akseliahonpera/embedded_systems_course_26/README.md

# embedded_systems_course_26
Repo for embedded systems course project in uni Oulu. Project theme is a drone system.

asdf
