akseliahonpera/embedded_systems_course_26/KiCad_libraries/readme.txt

Tänne saa laittaa komponentit mitä tarvii projektissa.

Näyttää siltä että seuraaville komponenteille tarvii footprintit ja symbolit:
BMP581
M20048-1
MP2235S

En tiiä liekkö netissä symboleita ja footprinttejä valmiina. ei kyllä pitäis olla paha homma tehdä itse.
