akseliahonpera/embedded_systems_course_26/bom.xls

Reference | Qty | Value | DNP | Footprint | DigiKey | Price / pcs | Price
C5,C27 | 2 | 22u |  | Capacitor_SMD:C_1206_3216Metric_Pad1.33x1.80mm_HandSolder | 587-3246-1-ND | 0.08 | 0.16
C6,C8,C15,C16,C18,C19,C20,C22,C23,C24 | 10 | 0.1u |  | Capacitor_SMD:C_0805_2012Metric_Pad1.18x1.45mm_HandSolder | 720-1754-1-ND | 0.18 | 1.8
C7,C10 | 2 | 2.2u |  | Capacitor_SMD:C_0805_2012Metric_Pad1.18x1.45mm_HandSolder | 399-C0805C225K4RACTUCT-ND | 0.36 | 0.72
C9,C11,C12,C13,C14 | 5 | 22p |  | Capacitor_SMD:C_0805_2012Metric_Pad1.18x1.45mm_HandSolder | 399-17625-1-ND | 0.11 | 0.55
C17 | 1 | 22n |  | Capacitor_SMD:C_0805_2012Metric_Pad1.18x1.45mm_HandSolder | 490-1644-1-ND | 0.21 | 0.21
C21 | 1 | 33p |  | Capacitor_SMD:C_0805_2012Metric_Pad1.18x1.45mm_HandSolder | 399-C0805C330J5GACTUCT-ND | 0.09 | 0.09
C25,C26 | 2 | 0 |  | Capacitor_SMD:C_1206_3216Metric_Pad1.33x1.80mm_HandSolder |  |  | 0 | Just extra pad, doesn’t cost anything
D1 | 1 | LED |  | LED_SMD:LED_0805_2012Metric_Pad1.15x1.40mm_HandSolder | 492-2281-1-ND | 0.56 | 0.56
D2 | 1 | D_Schottky |  | Diode_SMD:D_SOD-323_HandSoldering | CUS10S30H3FCT-ND | 0.18 | 0.18
D3 | 1 | 1N4148 |  | Diode_SMD:D_SOD-323F | 1N4148WSFSCT-ND | 0.09 | 0.09
J1 | 1 | Conn_01x08_Socket |  | Connector_PinSocket_2.54mm:PinSocket_1x08_P2.54mm_Vertical |  |  | 0
J2 | 1 | USB4105-GF-A |  | 1_project_library:USB4105_GCT | 2073-USB4105-GF-ACT-ND | 0.67 | 0.67
L1,L2 | 2 | 47n |  | Inductor_SMD:L_0805_2012Metric_Pad1.05x1.20mm_HandSolder | 445-1032-1-ND | 0.09 | 0.18
L3 | 1 | 1.8n |  | Inductor_SMD:L_0805_2012Metric_Pad1.05x1.20mm_HandSolder | 2035-1135-1-ND | 0.14 | 0.14
L4 | 1 | SRU1038-5R0Y |  | 1_project_library:IND_BOURNS_SRU1038 | SRU1038-5R0YCT-ND | 0.69 | 0.69
Q2 | 1 | DMP3099L |  | Package_TO_SOT_SMD:SOT-23 | DMP3099L-7DICT-ND | 0.27 | 0.27
R1,R17,R18,R21,R22 | 5 | 2.2k |  | Resistor_SMD:R_0805_2012Metric_Pad1.20x1.40mm_HandSolder | 311-2.20KCRCT-ND | 0.09 | 0.45
R6,R7 | 2 | 5.1k |  | Resistor_SMD:R_0805_2012Metric_Pad1.20x1.40mm_HandSolder | P5.1KDACT-ND | 0.09 | 0.18
R8 | 2 | 10K |  | Resistor_SMD:R_0805_2012Metric_Pad1.20x1.40mm_HandSolder | 541-10.0KCCT-ND | 0.09 | 0.18
R9,R20 | 2 | 0 |  | Resistor_SMD:R_0805_2012Metric_Pad1.20x1.40mm_HandSolder | 311-0.0ARCT-ND | 0.09 | 0.18
R10 | 1 | 100k |  | Resistor_SMD:R_0805_2012Metric_Pad1.20x1.40mm_HandSolder | 311-100KCRCT-ND | 0.09 | 0.09
R11 | 1 | 20 |  | Resistor_SMD:R_0805_2012Metric_Pad1.20x1.40mm_HandSolder | 311-20.0CRCT-ND | 0.09 | 0.09
R12 | 1 | 5.6k |  | Resistor_SMD:R_0805_2012Metric_Pad1.20x1.40mm_HandSolder | 13-RC0805FR-135K6LCT-ND | 0.09 | 0.09
R13 | 1 | 13k |  | Resistor_SMD:R_0805_2012Metric_Pad1.20x1.40mm_HandSolder | 13-RT0805FRE0713KLCT-ND | 0.09 | 0.09
R14 | 1 | 40.2k |  | Resistor_SMD:R_0805_2012Metric_Pad1.20x1.40mm_HandSolder | 311-40.2KCRCT-ND | 0.09 | 0.09
R15 | 1 | 470k |  | Resistor_SMD:R_0805_2012Metric_Pad1.20x1.40mm_HandSolder | 311-470KCRCT-ND | 0.09 | 0.09
R16,R23 | 2 | 10k |  | Resistor_SMD:R_0805_2012Metric_Pad1.20x1.40mm_HandSolder | 541-10.0KCCT-ND | 0.09 | 0.18
U1 | 1 | B3U-1000P |  | B3U-1000P | SW1020CT-ND | 0.75 | 0.75
U2 | 1 | 1060 |  | 1_project_library:1060_KEY | 36-1060-ND | 1.16 | 1.16
U7 | 1 | LTC4412xS6 |  | Package_TO_SOT_SMD:TSOT-23-6 | 505-LTC4412ES6#TRMPBFCT-ND | 4.31 | 4.31
U8 | 1 | ~ |  | Package_TO_SOT_SMD:TSOT-23-8 | 1589-1573-1-ND | 1.43 | 1.43
U10 | 1 | M20048-1 |  | 1_project_library:QFN28_M20048-1_ANT | 627-1099-1-ND | 14.48 | 14.48
U11 | 1 | BMP581 |  | 1_project_library:QFN10_BMP581_BOS | 828-BMP581CT-ND | 2.5 | 2.5
U12 | 1 | ESP32-S3-MINI-1U |  | RF_Module:ESP32-S2-MINI-1U | 1965-ESP32-S3-MINI-1U-N8CT-ND | 4.52 | 4.52
U13 | 1 | BNO085 |  | 1_project_library:BNO085 | 1888-1006-1-ND | 11.17 | 11.17
 | 1 | ST0126-30-501-A |  |  | 115-ST0126-30-501-A-ND | 9.39 | 9.39
 | 1 | CAB.A02 |  |  | 931-1100-ND | 3.41 | 3.41
 | 1 | SLW-171175-7A-N-D |  |  | 2223-SLW-171175-7A-N-D-ND | 0.48 | 0.48
 |  |  |  |  |  |  | 61.62
