akseliahonpera/embedded_systems_course_26/software/opengl_visualization_app/src/assets/drone.obj

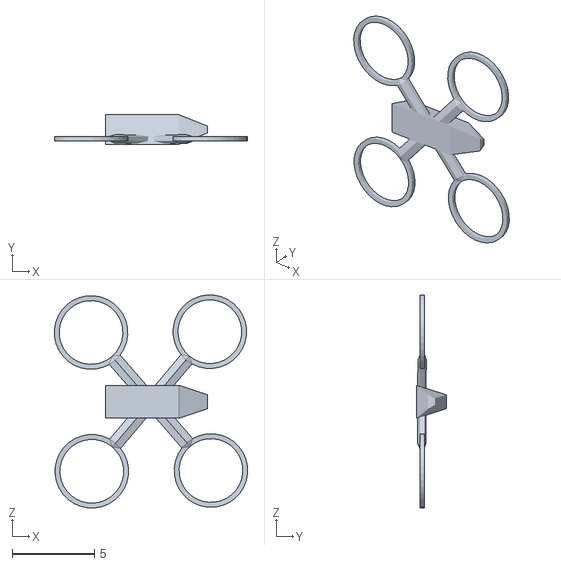
[picture p1: CAD file, 2026-09-06]
software/opengl_visualization_app/src/assets/drone.obj
11.8 x 1.80 x 13.0
