akseliahonpera/embedded_systems_course_26/software/opengl_visualization_app/src/assets/prop.obj

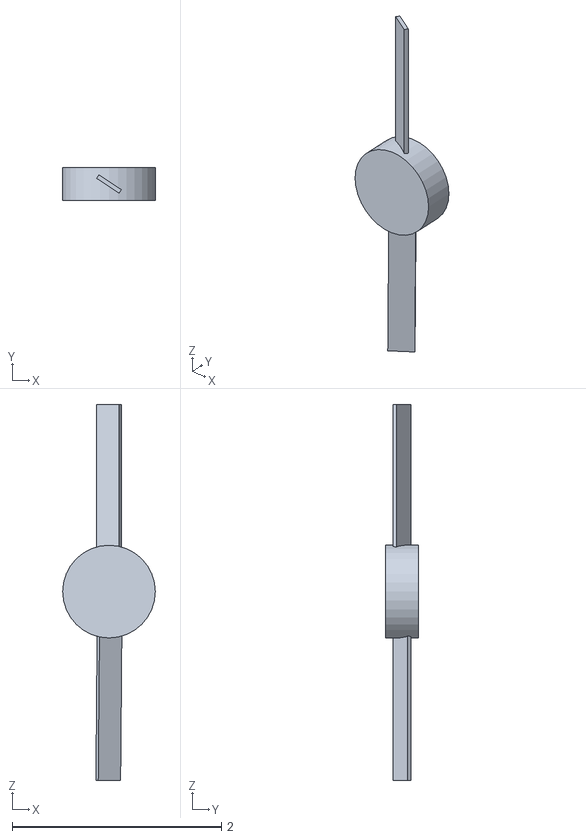
[picture p2: CAD file, 2026-09-06]
software/opengl_visualization_app/src/assets/prop.obj
0.886 x 0.314 x 3.59
