akseliahonpera/embedded_systems_course_26/KiCad_files/esp.kicad_pcb

## KiCad design KiCad_files/esp.kicad_pcb (2026-04-12)

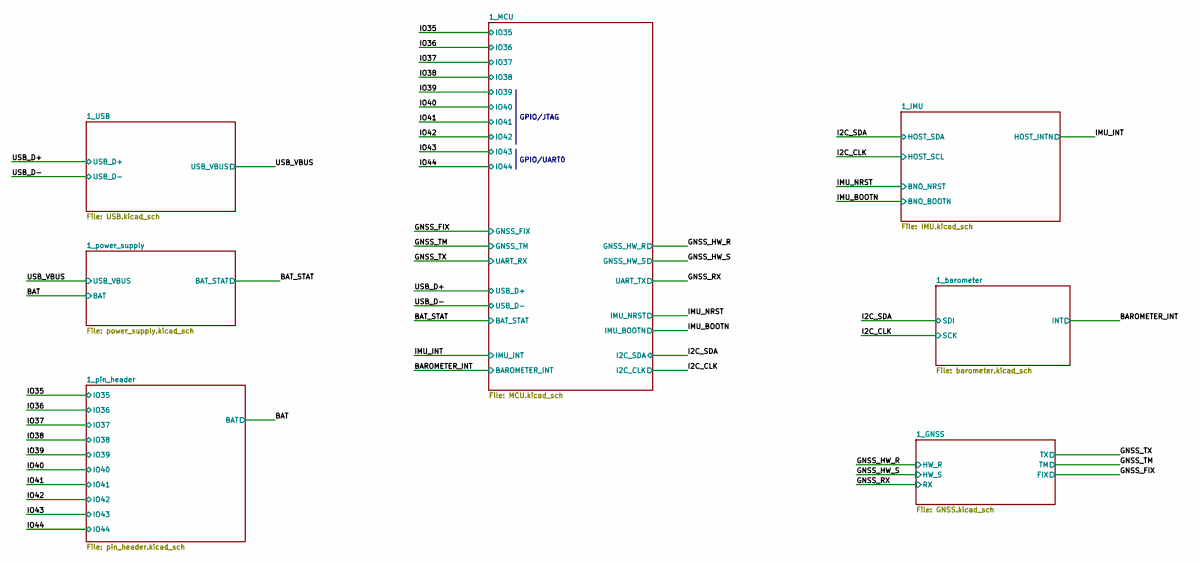
[picture p3: schematic esp.kicad_sch]

Notes on the sheet:
GPIO/JTAG
GPIO/UART0

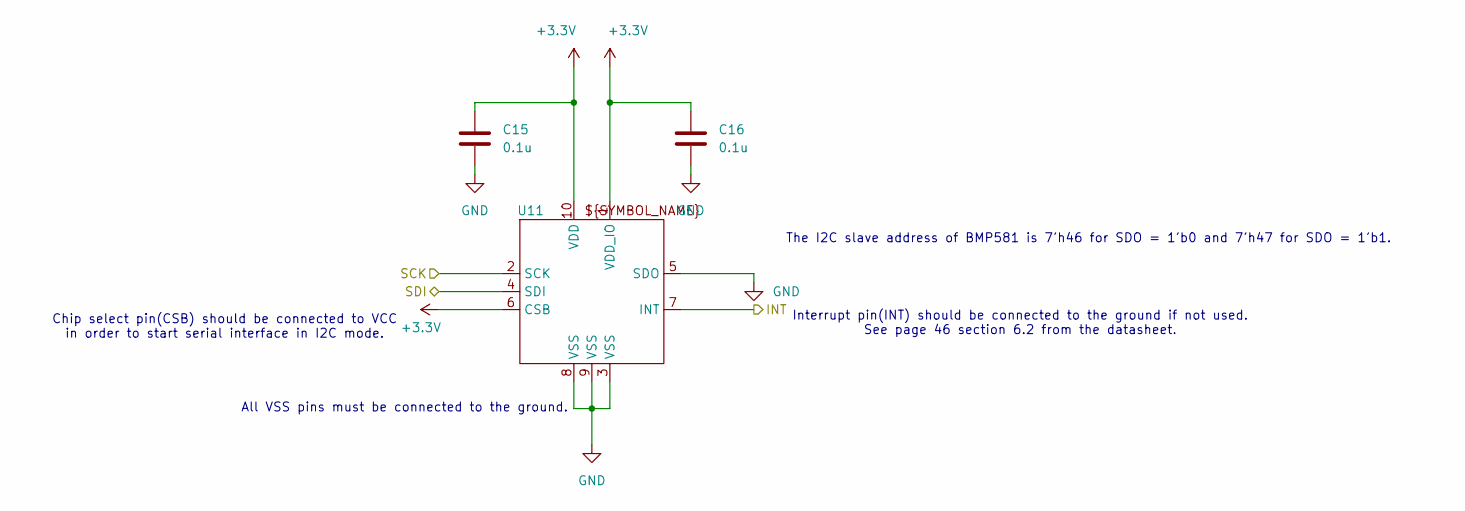
[picture p4: schematic barometer.kicad_sch]

Parts:
C15, C16: 0.1u; C_0805_2012Metric_Pad1.18x1.45mm_HandSolder; DigiKey 720-1754-1-ND
U11: QFN10_BMP581_BOS; DigiKey 828-BMP581CT-ND

Connections:
+3.3V: C15.1, C16.1, U11.1 (VDD_IO), U11.6 (CSB), U11.10 (VDD); also elsewhere on the board
/BAROMETER_INT: U11.7 (INT); also elsewhere on the board
/I2C_CLK: U11.2 (SCK); also elsewhere on the board
/I2C_SDA: U11.4 (SDI); also elsewhere on the board
GND: C15.2, C16.2, U11.3 (VSS), U11.5 (SDO), U11.8 (VSS), U11.9 (VSS); also elsewhere on the board

Notes on the sheet:
Chip select pin(CSB) should be connected to VCC in order to start serial interface in I2C mode.
The I2C slave address of BMP581 is 7'h46 for SDO = 1'b0 and 7'h47 for SDO = 1'b1.
All VSS pins must be connected to the ground.
Interrupt pin(INT) should be connected to the ground if not used. See page 46 section 6.2 from the datasheet.

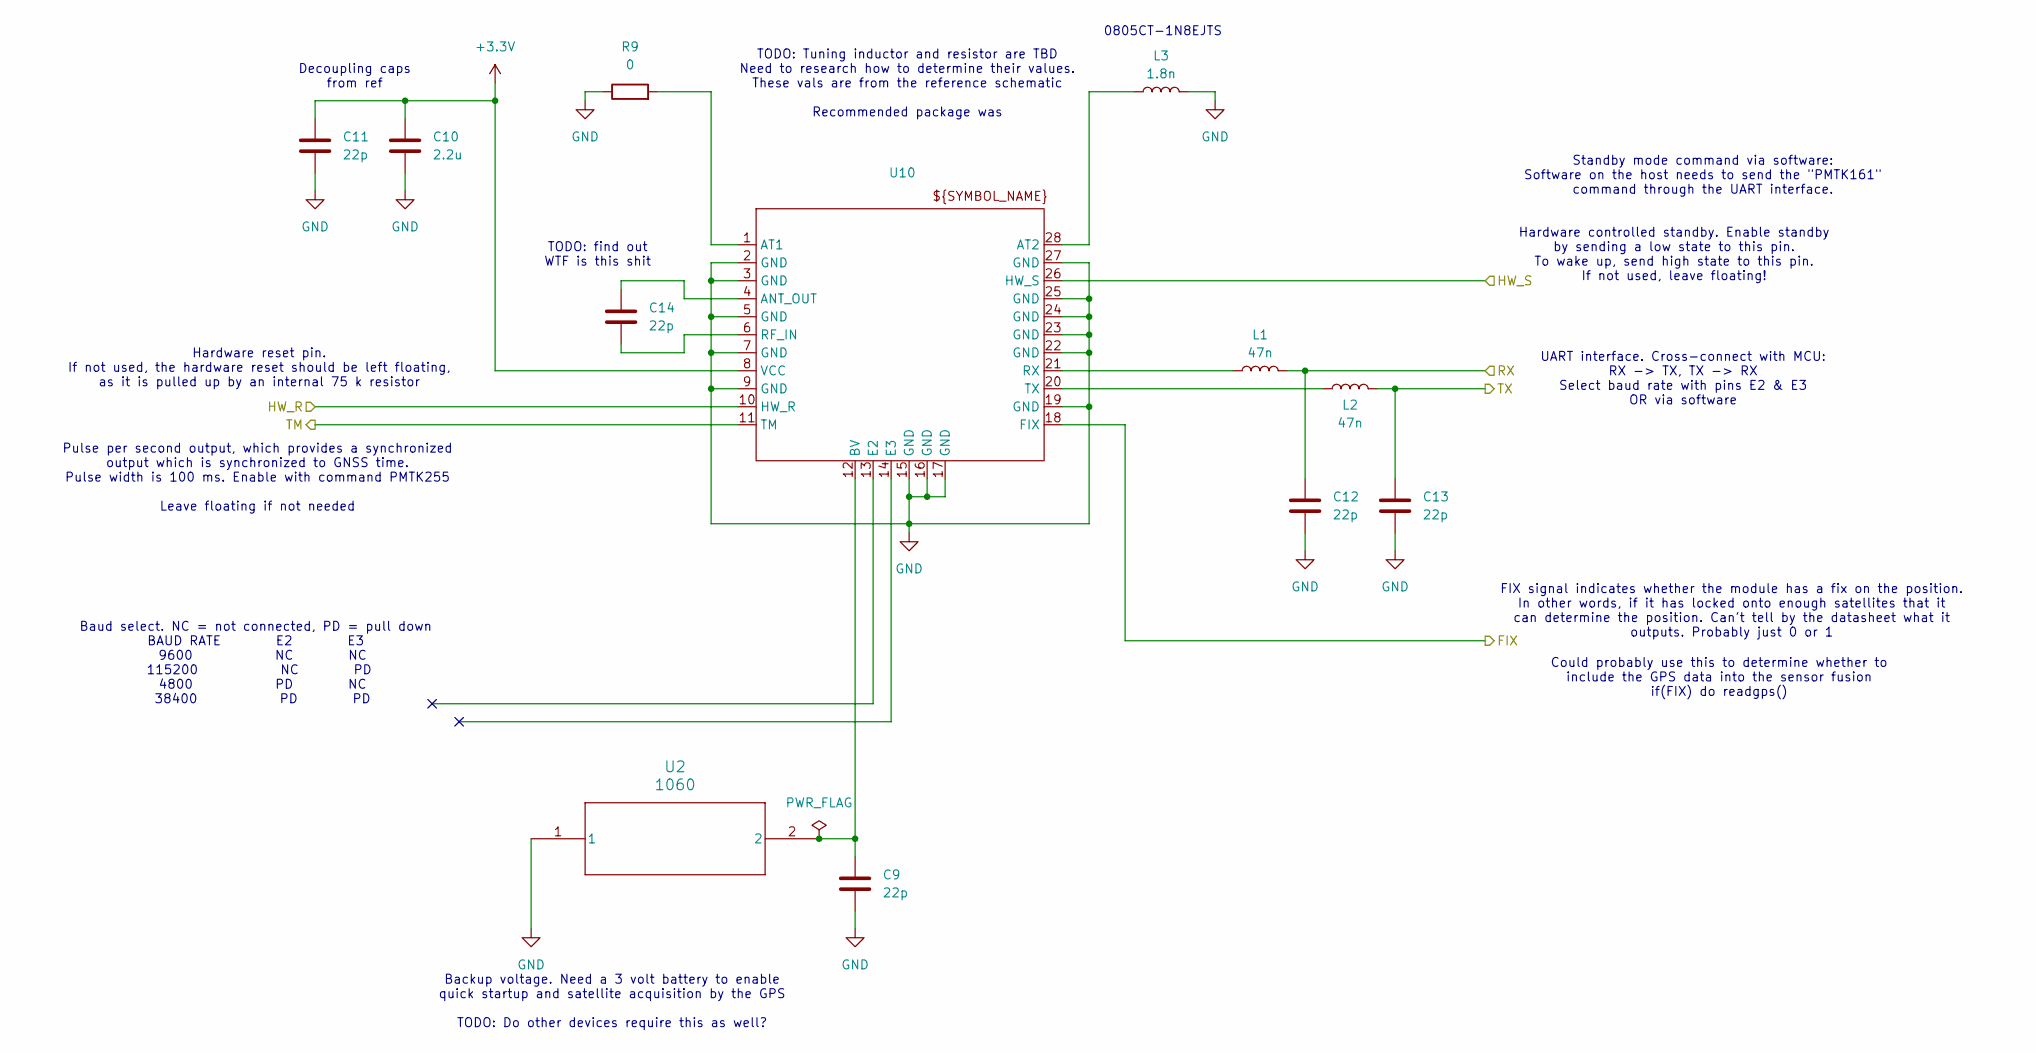
[picture p5: schematic GNSS.kicad_sch]

Parts:
C9, C11, C12, C13, C14: 22p; C_0805_2012Metric_Pad1.18x1.45mm_HandSolder; DigiKey 399-17625-1-ND
C10: 2.2u; C_0805_2012Metric_Pad1.18x1.45mm_HandSolder; DigiKey 399-C0805C225K4RACTUCT-ND
L1, L2: 47n; L_0805_2012Metric_Pad1.05x1.20mm_HandSolder; DigiKey 445-1032-1-ND
L3: 1.8n; L_0805_2012Metric_Pad1.05x1.20mm_HandSolder; DigiKey 2035-1135-1-ND
R9: 0; R_0805_2012Metric_Pad1.20x1.40mm_HandSolder; DigiKey 311-0.0ARCT-ND
U2: 1060; 1060_KEY; DigiKey 36-1060-ND
U10: QFN28_M20048-1_ANT; DigiKey 627-1099-1-ND

Connections:
+3.3V: C10.1, C11.1, U10.8 (VCC); also elsewhere on the board
/GNSS_FIX: U10.18 (FIX); also elsewhere on the board
/GNSS_HW_R: U10.10 (HW_R); also elsewhere on the board
/GNSS_HW_S: U10.26 (HW_S); also elsewhere on the board
/GNSS_RX: C12.1, L1.2; also elsewhere on the board
/GNSS_TM: U10.11 (TM); also elsewhere on the board
/GNSS_TX: C13.1, L2.2; also elsewhere on the board
GND: C9.2, C10.2, C11.2, C12.2, C13.2, L3.2, R9.1, U2.1, U10.2 (GND), U10.3 (GND), U10.5 (GND), U10.7 (GND), U10.9 (GND), U10.15 (GND), U10.16 (GND), U10.17 (GND), U10.19 (GND), U10.22 (GND), U10.23 (GND), U10.24 (GND), U10.25 (GND), U10.27 (GND); also elsewhere on the board
unnamed: C14.1, U10.4 (ANT_OUT)
unnamed: R9.2, U10.1 (AT1)
unnamed: L3.1, U10.28 (AT2)
unnamed: C9.1, U2.2, U10.12 (BV)
unnamed: C14.2, U10.6 (RF_IN)
unnamed: L1.1, U10.21 (RX)
unnamed: L2.1, U10.20 (TX)

Notes on the sheet:
Backup voltage. Need a 3 volt battery to enable quick startup and satellite acquisition by the GPS TODO: Do other devices require this as well?
Could probably use this to determine whether to include the GPS data into the sensor fusion if(FIX) do readgps()
UART interface. Cross-connect with MCU: RX -> TX, TX -> RX Select baud rate with pins E2 & E3 OR via software
0805CT-1N8EJTS
Hardware reset pin. If not used, the hardware reset should be left floating, as it is pulled up by an internal 75 k resistor
Baud select. NC = not connected, PD = pull down BAUD RATE E2 E3 9600 NC NC 115200 NC PD 4800 PD NC 38400 PD PD
TODO: Tuning inductor and resistor are TBD Need to research how to determine their values. These vals are from the reference schematic Recommended package was
FIX signal indicates whether the module has a fix on the position. In other words, if it has locked onto enough satellites that it can determine the position. Can't tell by the datasheet what it outputs. Probably just 0 or 1
Pulse per second output, which provides a synchronized output which is synchronized to GNSS time. Pulse width is 100 ms. Enable with command PMTK255 Leave floating if not needed
Hardware controlled standby. Enable standby by sending a low state to this pin. To wake up, send high state to this pin. If not used, leave floating!
Standby mode command via software: Software on the host needs to send the "PMTK161" command through the UART interface.
TODO: find out WTF is this shit
Decoupling caps from ref

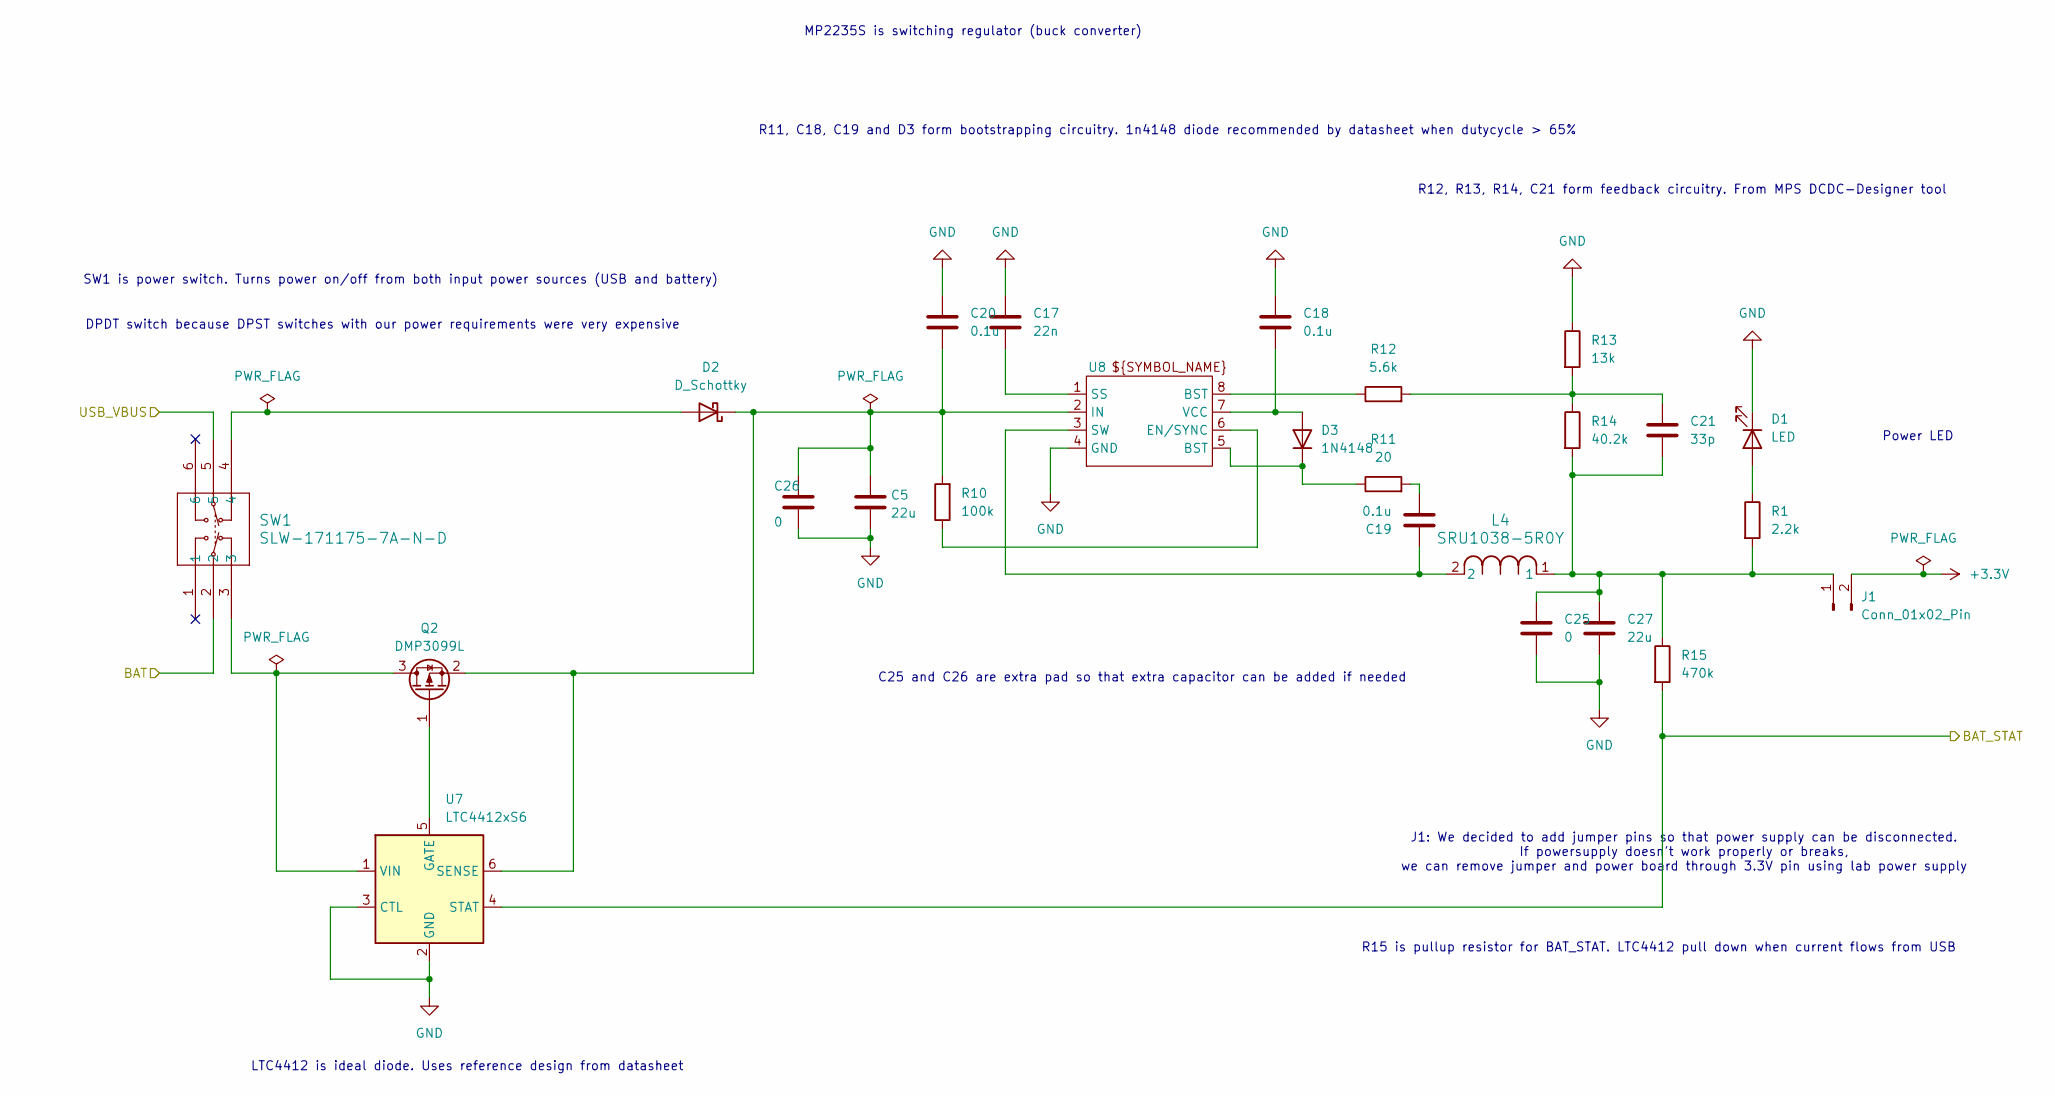
[picture p6: schematic power_supply.kicad_sch]

Parts:
C5, C27: 22u; C_1206_3216Metric_Pad1.33x1.80mm_HandSolder; DigiKey 587-3246-1-ND
C17: 22n; C_0805_2012Metric_Pad1.18x1.45mm_HandSolder; DigiKey 490-1644-1-ND
C18, C19, C20: 0.1u; C_0805_2012Metric_Pad1.18x1.45mm_HandSolder; DigiKey 720-1754-1-ND
C21: 33p; C_0805_2012Metric_Pad1.18x1.45mm_HandSolder; DigiKey 399-C0805C330J5GACTUCT-ND
C25, C26: 0; C_1206_3216Metric_Pad1.33x1.80mm_HandSolder
D1: LED; LED_0805_2012Metric_Pad1.15x1.40mm_HandSolder; DigiKey 492-2281-1-ND
D2: D_Schottky; D_SOD-323_HandSoldering; DigiKey CUS10S30H3FCT-ND
D3: 1N4148; D_SOD-323F; DigiKey 1N4148WSFSCT-ND
J1: Conn_01x02_Pin; PinHeader_1x02_P2.54mm_Vertical
L4: SRU1038-5R0Y; IND_BOURNS_SRU1038; DigiKey SRU1038-5R0YCT-ND
Q2: DMP3099L; SOT-23; DigiKey DMP3099L-7DICT-ND
R1: 2.2k; R_0805_2012Metric_Pad1.20x1.40mm_HandSolder; DigiKey 311-2.20KCRCT-ND
R10: 100k; R_0805_2012Metric_Pad1.20x1.40mm_HandSolder; DigiKey 311-100KCRCT-ND
R11: 20; R_0805_2012Metric_Pad1.20x1.40mm_HandSolder; DigiKey 311-20.0CRCT-ND
R12: 5.6k; R_0805_2012Metric_Pad1.20x1.40mm_HandSolder; DigiKey 13-RC0805FR-135K6LCT-ND
R13: 13k; R_0805_2012Metric_Pad1.20x1.40mm_HandSolder; DigiKey 13-RT0805FRE0713KLCT-ND
R14: 40.2k; R_0805_2012Metric_Pad1.20x1.40mm_HandSolder; DigiKey 311-40.2KCRCT-ND
R15: 470k; R_0805_2012Metric_Pad1.20x1.40mm_HandSolder; DigiKey 311-470KCRCT-ND
SW1: SLW-171175-7A-N-D; SLW-171175-7A-N-D_SSD; DigiKey 2223-SLW-171175-7A-N-D-ND
U7: LTC4412xS6; TSOT-23-6; DigiKey 505-LTC4412ES6#TRMPBFCT-ND
U8: TSOT-23-8; DigiKey 1589-1573-1-ND

Connections:
+3.3V: J1.2; also elsewhere on the board
/BAT: SW1.2; also elsewhere on the board
/BAT_STAT: R15.2, U7.4 (STAT); also elsewhere on the board
/USB_VBUS: SW1.5; also elsewhere on the board
GND: C5.2, C17.1, C18.1, C20.1, C25.2, C26.2, C27.2, D1.1 (K), R13.1, U7.2 (GND), U7.3 (CTL), U8.4 (GND); also elsewhere on the board
unnamed: C19.2, R11.2
unnamed: C21.1, R12.2, R13.2, R14.1
unnamed: D1.2 (A), R1.1
unnamed: D2.2 (A), SW1.4
unnamed: C5.1, C20.2, C26.1, D2.1 (K), Q2.2 (S), R10.2, U7.6 (SENSE), U8.2 (IN)
unnamed: C18.2, D3.2 (A), U8.7 (VCC)
unnamed: D3.1 (K), R11.1, U8.5 (BST)
unnamed: C21.2, C25.1, C27.1, J1.1, L4.1, R1.2, R14.2, R15.1
unnamed: Q2.3 (D), SW1.3, U7.1 (VIN)
unnamed: Q2.1 (G), U7.5 (GATE)
unnamed: R12.1, U8.8 (BST)
unnamed: R10.1, U8.6 (EN/SYNC)
unnamed: C17.2, U8.1 (SS)
unnamed: C19.1, L4.2, U8.3 (SW)

Notes on the sheet:
C25 and C26 are extra pad so that extra capacitor can be added if needed
SW1 is power switch. Turns power on/off from both input power sources (USB and battery)
R12, R13, R14, C21 form feedback circuitry. From MPS DCDC-Designer tool
R11, C18, C19 and D3 form bootstrapping circuitry. 1n4148 diode recommended by datasheet when dutycycle > 65%
Power LED
R15 is pullup resistor for BAT_STAT. LTC4412 pull down when current flows from USB
LTC4412 is ideal diode. Uses reference design from datasheet
J1: We decided to add jumper pins so that power supply can be disconnected. If powersupply doesn't work properly or breaks, we can remove jumper and power board through 3.3V pin using lab power supply
MP2235S is switching regulator (buck converter)
DPDT switch because DPST switches with our power requirements were very expensive

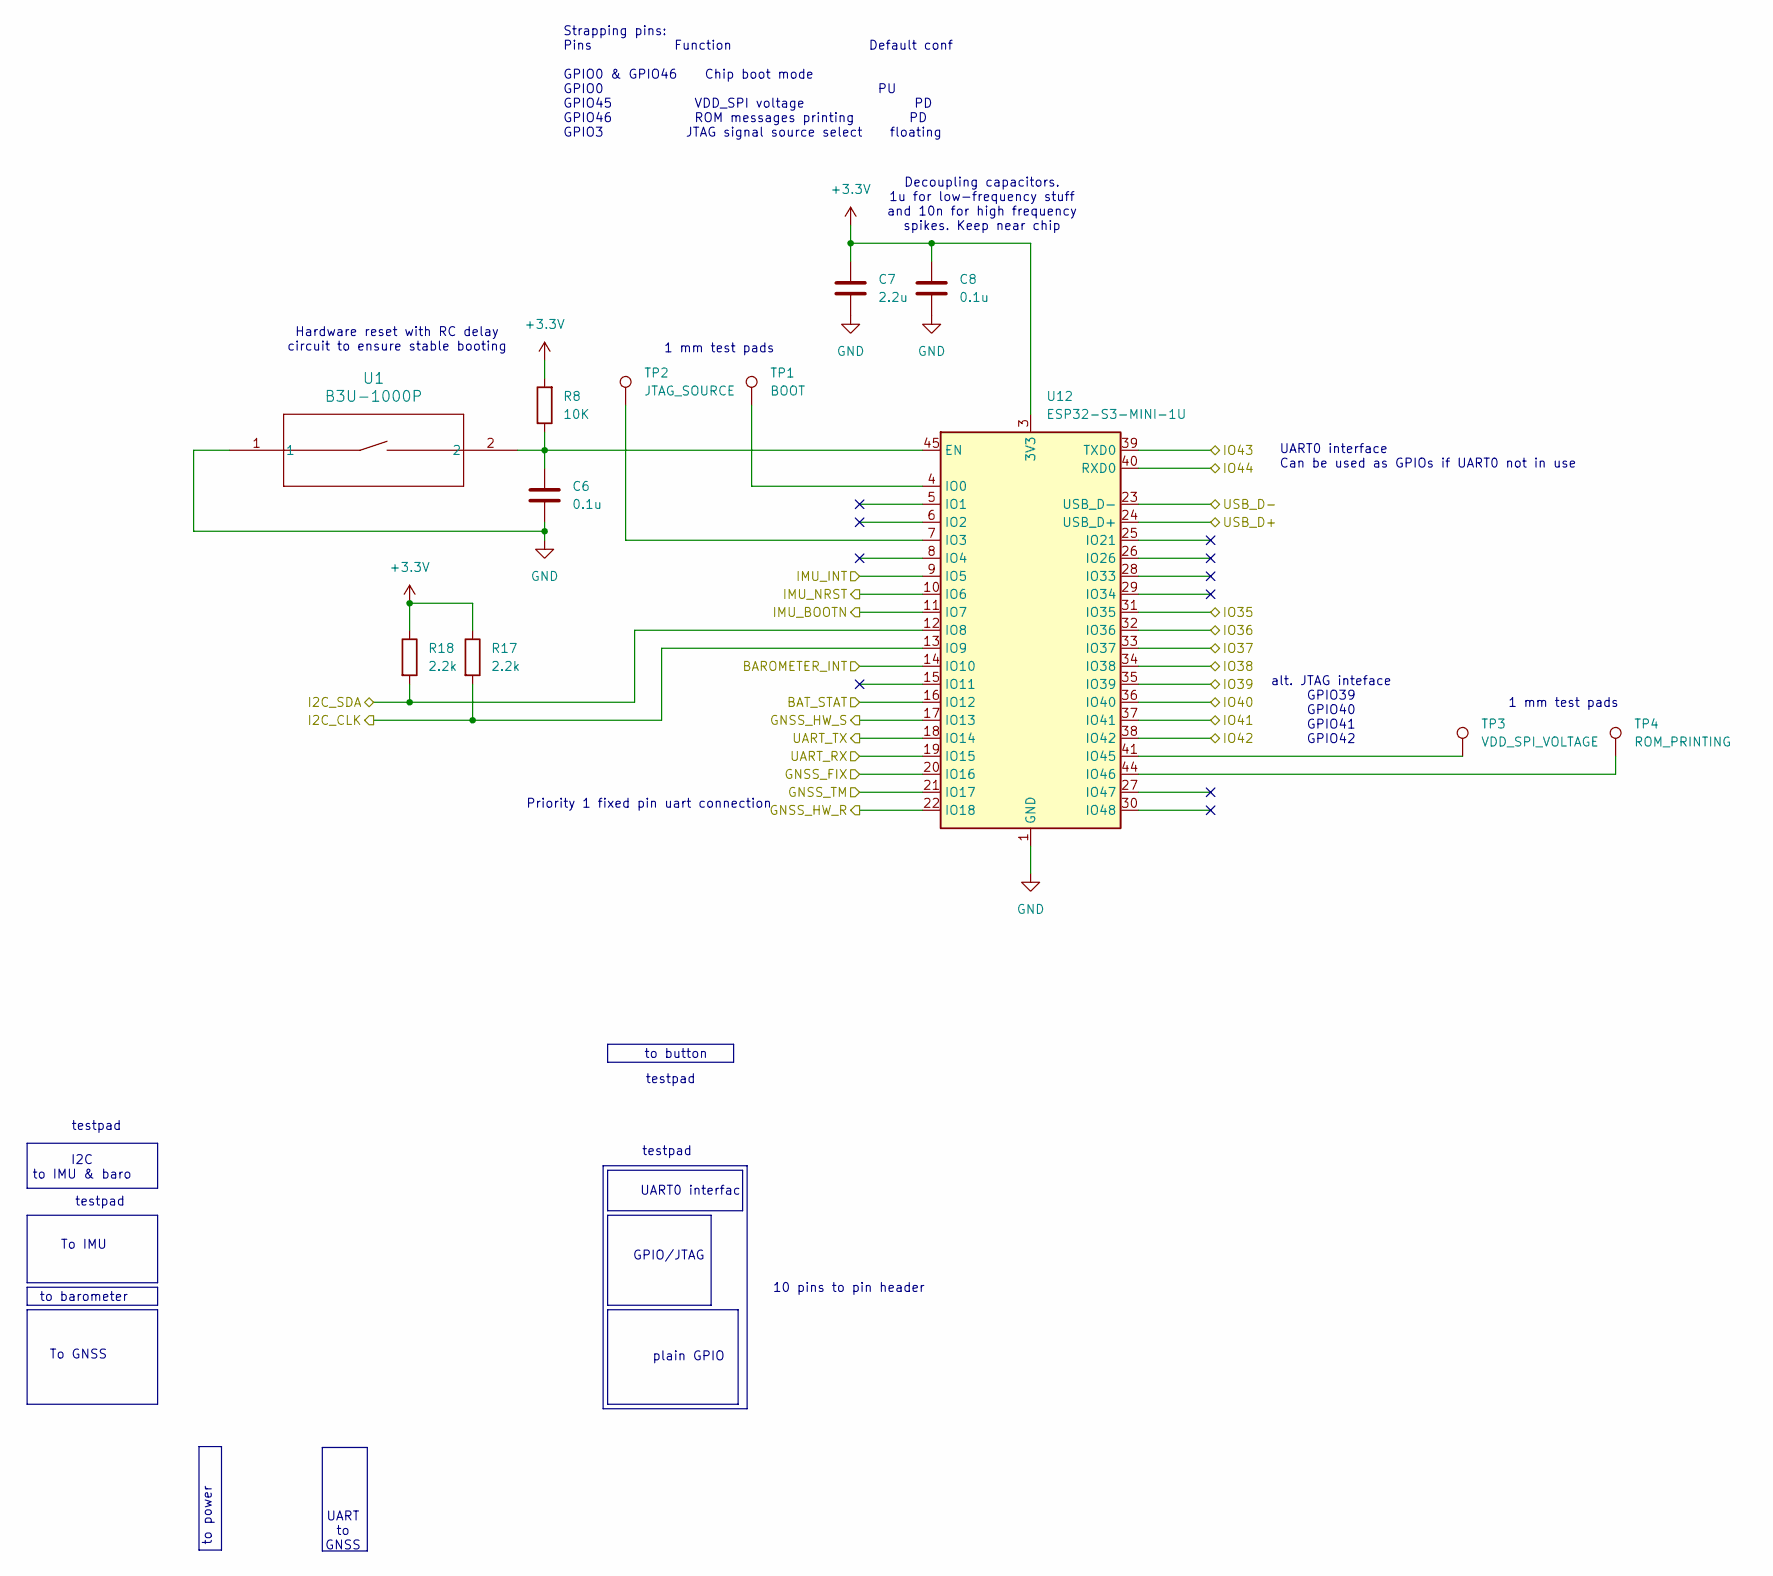
[picture p7: schematic MCU.kicad_sch]

Parts:
C6, C8: 0.1u; C_0805_2012Metric_Pad1.18x1.45mm_HandSolder; DigiKey 720-1754-1-ND
C7: 2.2u; C_0805_2012Metric_Pad1.18x1.45mm_HandSolder; DigiKey 399-C0805C225K4RACTUCT-ND
R8: 10K; R_0805_2012Metric_Pad1.20x1.40mm_HandSolder; DigiKey 541-10.0KCCT-ND
R17, R18: 2.2k; R_0805_2012Metric_Pad1.20x1.40mm_HandSolder; DigiKey 311-2.20KCRCT-ND
TP1: BOOT; TestPoint_Pad_D1.0mm
TP2: JTAG_SOURCE; TestPoint_Pad_D1.0mm
TP3: VDD_SPI_VOLTAGE; TestPoint_Pad_D1.0mm
TP4: ROM_PRINTING; TestPoint_Pad_D1.0mm
U1: B3U-1000P; DigiKey SW1020CT-ND
U12: ESP32-S3-MINI-1U; ESP32-S2-MINI-1U; DigiKey 1965-ESP32-S3-MINI-1U-N8CT-ND

Connections:
+3.3V: C7.1, C8.1, R8.2, R17.1, R18.1, U12.3 (3V3); also elsewhere on the board
/BAROMETER_INT: U12.14 (IO10); also elsewhere on the board
/BAT_STAT: U12.16 (IO12); also elsewhere on the board
/GNSS_FIX: U12.20 (IO16); also elsewhere on the board
/GNSS_HW_R: U12.22 (IO18); also elsewhere on the board
/GNSS_HW_S: U12.17 (IO13); also elsewhere on the board
/GNSS_RX: U12.18 (IO14); also elsewhere on the board
/GNSS_TM: U12.21 (IO17); also elsewhere on the board
/GNSS_TX: U12.19 (IO15); also elsewhere on the board
/I2C_CLK: R17.2, U12.13 (IO9); also elsewhere on the board
/I2C_SDA: R18.2, U12.12 (IO8); also elsewhere on the board
/IMU_BOOTN: U12.11 (IO7); also elsewhere on the board
/IMU_INT: U12.9 (IO5); also elsewhere on the board
/IMU_NRST: U12.10 (IO6); also elsewhere on the board
/IO35: U12.31 (IO35); also elsewhere on the board
/IO36: U12.32 (IO36); also elsewhere on the board
/IO37: U12.33 (IO37); also elsewhere on the board
/IO38: U12.34 (IO38); also elsewhere on the board
/IO39: U12.35 (IO39); also elsewhere on the board
/IO40: U12.36 (IO40); also elsewhere on the board
/IO41: U12.37 (IO41); also elsewhere on the board
/IO42: U12.38 (IO42); also elsewhere on the board
/IO43: U12.39 (TXD0); also elsewhere on the board
/IO44: U12.40 (RXD0); also elsewhere on the board
/USB_D+: U12.24 (USB_D+); also elsewhere on the board
/USB_D-: U12.23 (USB_D-); also elsewhere on the board
GND: C6.2, C7.2, C8.2, U1.1, U12.1 (GND), U12.2 (GND), U12.42 (GND), U12.43 (GND), U12.46 (GND), U12.47 (GND), U12.48 (GND), U12.49 (GND), U12.50 (GND), U12.51 (GND), U12.52 (GND), U12.53 (GND), U12.54 (GND), U12.55 (GND), U12.56 (GND), U12.57 (GND), U12.58 (GND), U12.59 (GND), U12.60 (GND), U12.61 (GND), U12.62 (GND), U12.63 (GND), U12.64 (GND), U12.65 (GND); also elsewhere on the board
unnamed: C6.1, R8.1, U1.2, U12.45 (EN)
unnamed: TP1.1, U12.4 (IO0)
unnamed: TP2.1, U12.7 (IO3)
unnamed: TP3.1, U12.41 (IO45)
unnamed: TP4.1, U12.44 (IO46)

Notes on the sheet:
Priority 1 fixed pin uart connection
1 mm test pads
I2C to IMU & baro
GPIO/JTAG
testpad
to power
Hardware reset with RC delay circuit to ensure stable booting
plain GPIO
alt. JTAG inteface GPIO39 GPIO40 GPIO41 GPIO42
Decoupling capacitors. 1u for low-frequency stuff and 10n for high frequency spikes. Keep near chip
UART to GNSS
To GNSS
UART0 interface Can be used as GPIOs if UART0 not in use
To IMU
UART0 interfac
10 pins to pin header
to button
Strapping pins: Pins Function Default conf GPIO0 & GPIO46 Chip boot mode GPIO0 PU GPIO45 VDD_SPI voltage PD GPIO46 ROM messages printing PD GPIO3 JTAG signal source select floating
to barometer

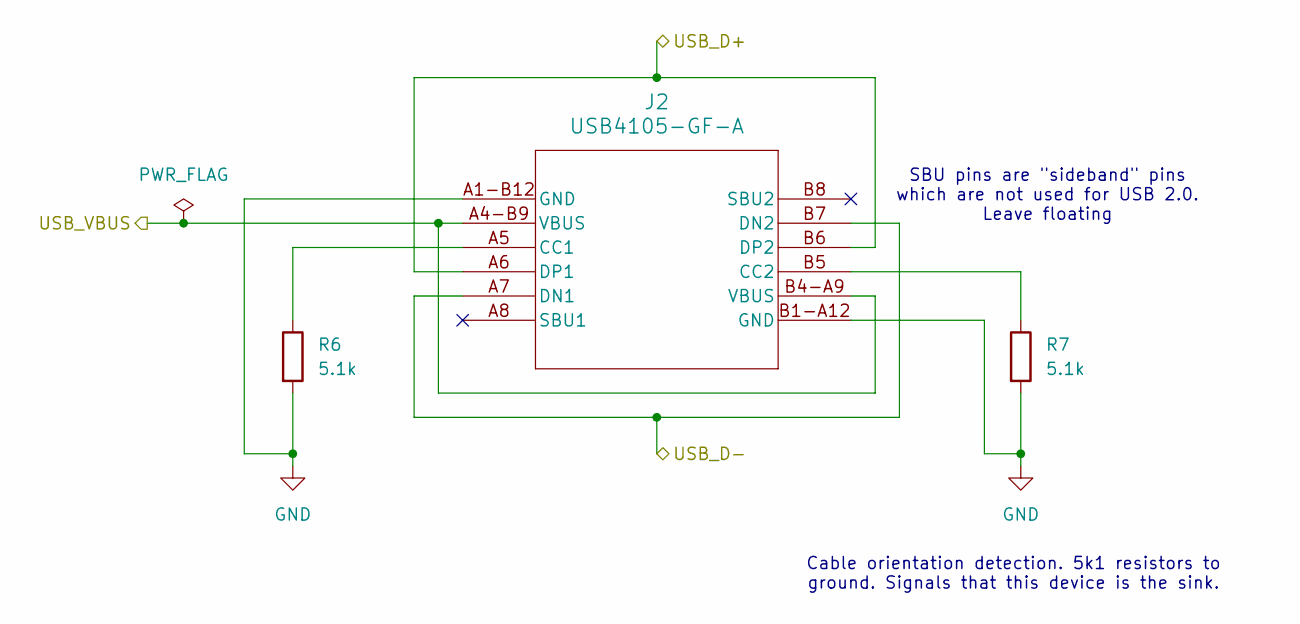
[picture p8: schematic USB.kicad_sch]

Parts:
J2: USB4105-GF-A; USB4105_GCT; DigiKey 2073-USB4105-GF-ACT-ND
R6, R7: 5.1k; R_0805_2012Metric_Pad1.20x1.40mm_HandSolder; DigiKey P5.1KDACT-ND

Connections:
/USB_D+: J2.A6 (DP1), J2.B6 (DP2); also elsewhere on the board
/USB_D-: J2.A7 (DN1), J2.B7 (DN2); also elsewhere on the board
/USB_VBUS: J2.A4-B9 (VBUS), J2.B4-A9 (VBUS); also elsewhere on the board
GND: J2.A1-B12 (GND), J2.B1-A12 (GND), R6.2, R7.2; also elsewhere on the board
unnamed: J2.A5 (CC1), R6.1
unnamed: J2.B5 (CC2), R7.1

Notes on the sheet:
Cable orientation detection. 5k1 resistors to ground. Signals that this device is the sink.
SBU pins are "sideband" pins which are not used for USB 2.0. Leave floating

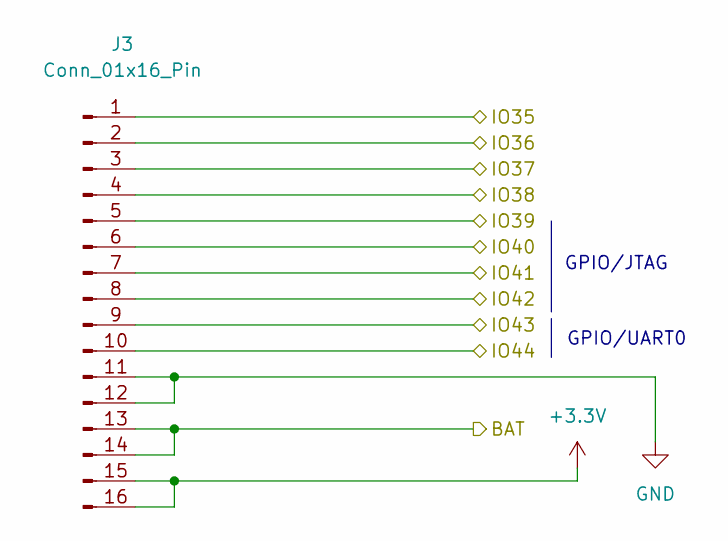
[picture p9: schematic pin_header.kicad_sch]

Parts:
J3: Conn_01x16_Pin; PinHeader_1x16_P2.54mm_Vertical

Connections:
+3.3V: J3.15, J3.16; also elsewhere on the board
/BAT: J3.13, J3.14; also elsewhere on the board
/IO35: J3.1; also elsewhere on the board
/IO36: J3.2; also elsewhere on the board
/IO37: J3.3; also elsewhere on the board
/IO38: J3.4; also elsewhere on the board
/IO39: J3.5; also elsewhere on the board
/IO40: J3.6; also elsewhere on the board
/IO41: J3.7; also elsewhere on the board
/IO42: J3.8; also elsewhere on the board
/IO43: J3.9; also elsewhere on the board
/IO44: J3.10; also elsewhere on the board
GND: J3.11, J3.12; also elsewhere on the board

Notes on the sheet:
GPIO/UART0
GPIO/JTAG

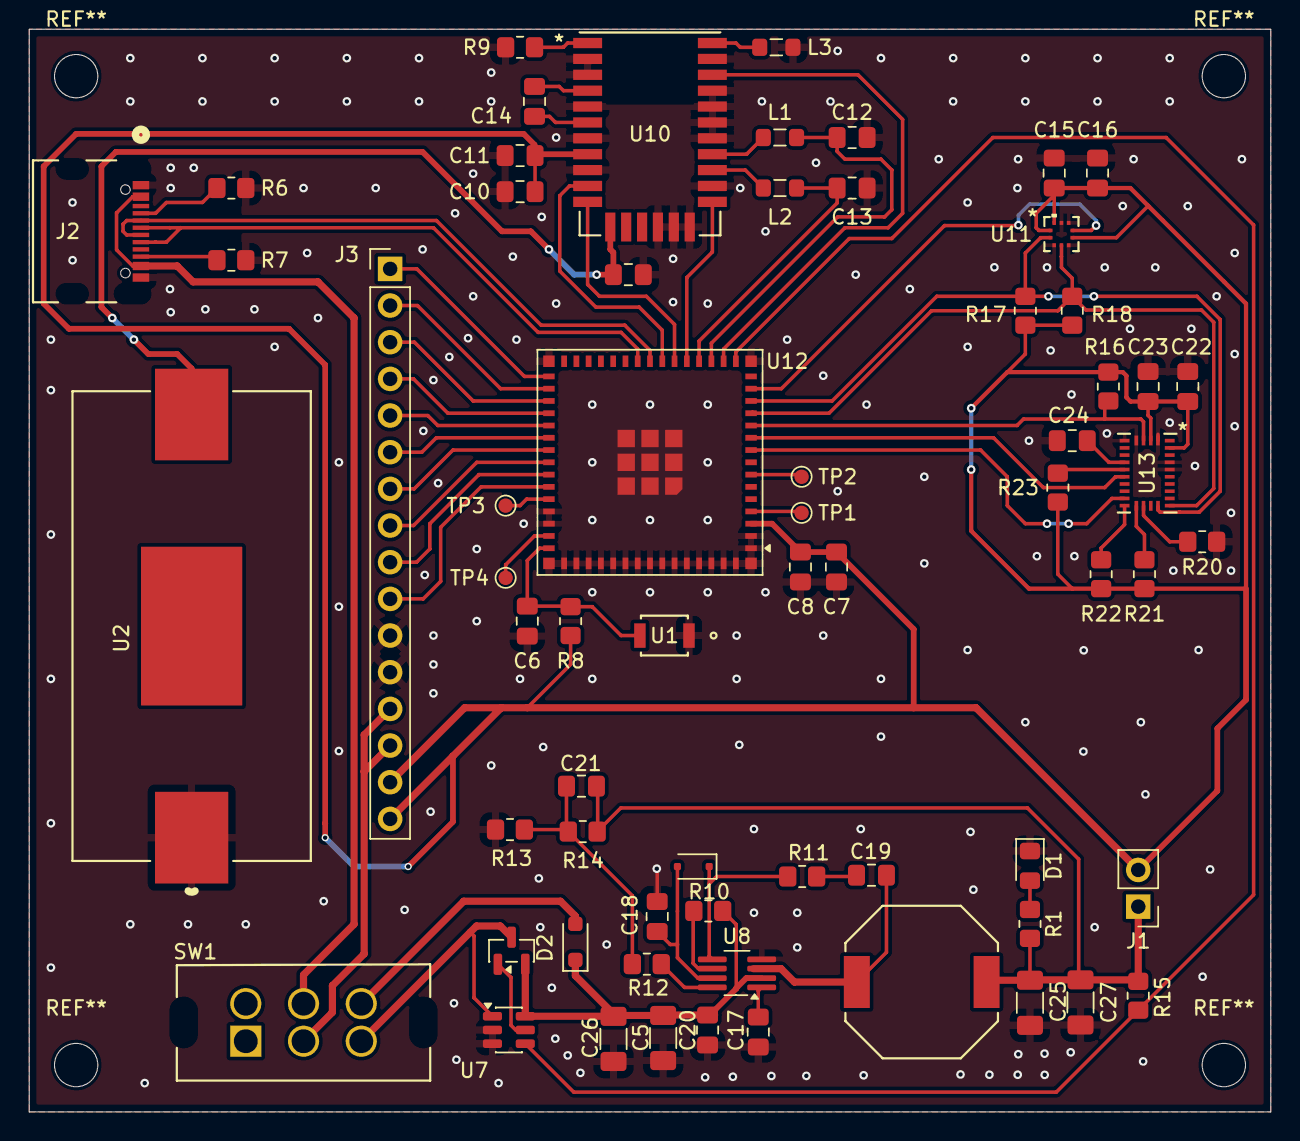
[picture p10: board esp.kicad_pcb from above]

Board: 2 copper layers, 86.0 x 75.0 mm, 65 parts (0 on the bottom side), 62 nets.

Other parts of the board:
C22, C23, C24: 0.1u; C_0805_2012Metric_Pad1.18x1.45mm_HandSolder
R16, R23: 10k; R_0805_2012Metric_Pad1.20x1.40mm_HandSolder
R20: 0; R_0805_2012Metric_Pad1.20x1.40mm_HandSolder
R21, R22: 2.2k; R_0805_2012Metric_Pad1.20x1.40mm_HandSolder
U13: BNO085

Their connections:
+3.3V: C22.1, C23.1, R16.1, R21.1, R22.1, R23.2, U13.3 (VDD), U13.28 (VDDIO); also elsewhere on the board
/I2C_CLK: U13.19 (H_SCL/SCK/RX); also elsewhere on the board
/I2C_SDA: U13.20 (H_SDA/H_MISO/TX); also elsewhere on the board
/IMU_BOOTN: R16.2, U13.4 (BOOTN); also elsewhere on the board
/IMU_INT: U13.14 (H_INTN); also elsewhere on the board
/IMU_NRST: U13.11 (NRST); also elsewhere on the board
GND: C22.2, C23.2, C24.2, R20.2, U13.2 (GND), U13.5 (PS1), U13.6 (PS0/WAKE), U13.25 (GND), U13.26 (XOUT32/CLKSEL1); also elsewhere on the board
unnamed: C24.1, U13.9 (CAP)
unnamed: R23.1, U13.10 (CLKSEL0)
unnamed: R22.2, U13.15 (ENV_SCL)
unnamed: R21.2, U13.16 (ENV_SDA)
unnamed: R20.1, U13.17 (SA0/H_MOSI)
