akseliahonpera/embedded_systems_course_26/software/opengl_visualization_app/src/main.cpp

#include <iostream>
#include "Utils.hpp"
#include "includes.hpp"

#include "imgui/imgui.h"
#include "imgui/imgui_impl_glfw.h"
#include "imgui/imgui_impl_opengl3.h"
#include "Application.hpp"



GLFWwindow* initDisplay(int width, int height)
{
    glfwInit();
    glfwWindowHint(GLFW_CONTEXT_VERSION_MAJOR, 3);
    glfwWindowHint(GLFW_CONTEXT_VERSION_MINOR, 3);
    glfwWindowHint(GLFW_OPENGL_PROFILE, GLFW_OPENGL_CORE_PROFILE);

    GLFWwindow* window = glfwCreateWindow(width, height, "Ground station", NULL, NULL);

    glfwMakeContextCurrent(window);

    glewInit();

    IMGUI_CHECKVERSION();
    ImGui::CreateContext();
    ImGuiIO& io = ImGui::GetIO();
    io.ConfigFlags |= ImGuiConfigFlags_NavEnableKeyboard;
    io.ConfigFlags |= ImGuiConfigFlags_NavEnableGamepad;

    ImGui::StyleColorsDark();
    ImGui_ImplGlfw_InitForOpenGL(window, true);
    ImGui_ImplOpenGL3_Init(nullptr);

    glEnable(GL_DEPTH_TEST);
    glEnable(GL_CULL_FACE);
    glCullFace(GL_BACK);
    glFrontFace(GL_CCW);
    glEnable(GL_MULTISAMPLE);
    glClearColor(0.1f, 0.1f, 0.2f, 1.0f);

    GLuint vao;
    glGenVertexArrays(1, &vao);
    glBindVertexArray(vao);

    return window;
}


int main(int args, char **arg)
{
    int window_width = 1280;
    int window_height = 720;

    GLFWwindow* window = initDisplay(window_width, window_height);
    Application app(window_width, window_height);

    float prev_time = Utils::getTimeStamp();

    while (!glfwWindowShouldClose(window))
    {
        glfwPollEvents();
        if (glfwGetWindowAttrib(window, GLFW_ICONIFIED) != 0)
        {
            ImGui_ImplGlfw_Sleep(10);
            continue;
        }

        int display_w, display_h;
        glfwGetFramebufferSize(window, &display_w, &display_h);
        glViewport(0, 0, display_w, display_h);
        glClear(GL_COLOR_BUFFER_BIT | GL_DEPTH_BUFFER_BIT);

        ImGui_ImplOpenGL3_NewFrame();
        ImGui_ImplGlfw_NewFrame();

        if (display_w != window_width || display_h != window_height) {
            window_width = display_w;
            window_height = display_h;
            app.windowResized(window_width, window_height);
        }


        float current_time = Utils::getTimeStamp();
        float delta_time = current_time - prev_time;
        prev_time = current_time;


        app.update(delta_time);
        app.render();

        ImGui::Render();
        ImGui_ImplOpenGL3_RenderDrawData(ImGui::GetDrawData());

        glFinish();
        glfwSwapBuffers(window);
    }

    glfwDestroyWindow(window);

    return 0;
}
