akseliahonpera/embedded_systems_course_26/software/DroneTelemetry/main/types.h

#ifndef TYPES_H
#define TYPES_H

#include "bmp5_defs.h" 
#include "sh2_SensorValue.h"
#include <stdbool.h>
#include <stdint.h> 
#include "nmea_parser.h"

//TODO: En tiiä tartteeko näitä, voi käyttää periaatteessa valmiitakin tietorakenteita muista headereista
// Tuota sh2_SensorValue_t:tä vois varmaa nvähän siistiä
//-------------------------------------------------------------------------------------------------
// Custom lightweight data structures:

typedef struct {
    double lon0_rad;
    double sin_lat0;
    double cos_lat0;
    double r0; // Origin distance from Earth's rotation axis, metres.
    double z0; // Origin ECEF z coordinate, metres.
} enu_reference_t;


typedef struct 
{
    float real;       // Quaternion real component
    float i;          // Quaternion i-component
    float j;          // Quaternion j-component
    float k;          // Quaternion k-component
    float accuracy;   // Accuracy estimate [radians]

} imu_rotation_data_t;

typedef struct 
{
    float acc_x;       
    float acc_y;          
    float acc_z;         
} imu_acceleration_data_t;

typedef struct 
{
    float cov_x;
    float cov_y;
    float cov_z;
} imu_covariance_data_t;


// Struct for barometer, derived from bmp5_defs.h
typedef struct
{
    float pressure;     // pressure (Pa)
    float temperature;  // temperature (°C)
} baro_data_t;


// Struct for imu, derived from sh2_SensorValue.h
typedef struct
{
    enum {ROTATION_DATA, ACCELERATION_DATA, COVARIANCE_DATA} data_type;

    union 
    {
        imu_rotation_data_t rotation_data;
        imu_acceleration_data_t acceleration_data;
        imu_covariance_data_t covariance_data;
    } data;

    uint64_t imu_internal_timestamp;
    uint8_t status;   // Reliability status of sensor (0=Unreliable ... 3=High)
    // From sh2_SensorValue.h:
    /* Status of a sensor
     *   0 - Unreliable
     *   1 - Accuracy low
     *   2 - Accuracy medium
     *   3 - Accuracy high
    */
} imu_data_t;

typedef struct
{
    float latitude;
    float longtitude;
    bool has_fix;
    gps_time_t tim; 
} gps_data_t;
//--------------------------------------------------------------------------------------------------

// Latest state published by the fusion task to telemetry.
typedef struct {
    float rotation[4];
    float location[3];
    float velocity[3];
    double latitude;
    double longtitude;
    float pressure;
    float temperature;
    uint32_t status;
} fusion_state_t;

typedef enum {
    SENSOR_BARO,
    SENSOR_IMU,
    SENSOR_GPS
} sensor_type_t;

// It's somewhat important to keep the memory footprint of this union low, because it goes into the sensorfusion queue.
// This union takes about 20 bytes of memory at the minimum because there are 4 floats in imu_data_t (r, i, j, k, accuracy)
typedef union {
    imu_data_t imu;
    baro_data_t baro;   // Joko kirjoitetaan ne omat datatyypit näille tai sitten käytetään valmiita headereista
    gps_data_t gps;
} sensor_payload_t;

// This is the message sent to fusion task
typedef struct {
    sensor_type_t type;
    int64_t timestamp;    // Some reason not uint64_t in esp_timer_get_time()
    sensor_payload_t data;
} sensor_msg_t;

// message sent to telemetry task
typedef struct {
    fusion_state_t state;
    int64_t timestamp; // ESP timer time in microseconds
} fusion_msg_t;


typedef struct {
    float position_east;
    float position_north;
    float position_up;      
    float velocity_east;
    float velocity_north;
    float velocity_up;         
    int64_t last_update;
    enu_reference_t origin;
    int gps_fix_counter;
    enum {IDLE, INIT, TRACKING} mode;

} kalman_state;



#endif
