akseliahonpera/embedded_systems_course_26/software/DroneTelemetry/main/comm/wifi_sta.c

#include <string.h>
#include <stdbool.h>
#include "freertos/FreeRTOS.h"
#include "freertos/event_groups.h"
#include "esp_wifi.h"
#include "esp_event.h"
#include "esp_netif.h"
#include "esp_log.h"
#include "esp_check.h"
#include "nvs_flash.h"
#include "wifi_sta.h"

static const char *TAG = "wifi_sta";

#define BIT_CONNECTED  BIT0
#define BIT_FAILED     BIT1
#define MAX_RETRY      10

static EventGroupHandle_t s_events;
static int s_retries;
static volatile bool s_connected;

static void on_wifi_event(void *arg, esp_event_base_t base, int32_t id, void *data)
{
    if (base == WIFI_EVENT && id == WIFI_EVENT_STA_START) {
        esp_wifi_connect();
    } else if (base == WIFI_EVENT && id == WIFI_EVENT_STA_DISCONNECTED) {
        s_connected = false;
        if (s_retries < MAX_RETRY) {
            s_retries++;
            ESP_LOGW(TAG, "disconnected, retry %d/%d", s_retries, MAX_RETRY);
            esp_wifi_connect();
        } else {
            /* Give up on the initial attempt, but keep trying forever once we
             * have been connected at least once (link may drop later). */
            xEventGroupSetBits(s_events, BIT_FAILED);
            vTaskDelay(pdMS_TO_TICKS(2000));
            esp_wifi_connect();
        }
    } else if (base == IP_EVENT && id == IP_EVENT_STA_GOT_IP) {
        ip_event_got_ip_t *e = (ip_event_got_ip_t *)data;
        ESP_LOGI(TAG, "got ip " IPSTR, IP2STR(&e->ip_info.ip));
        s_retries = 0;
        s_connected = true;
        xEventGroupSetBits(s_events, BIT_CONNECTED);
    }
}

bool wifi_sta_is_connected(void)
{
    return s_connected;
}

esp_err_t wifi_sta_start(const char *ssid, const char *password, uint32_t timeout_ms)
{
    ESP_RETURN_ON_FALSE(ssid, ESP_ERR_INVALID_ARG, TAG, "ssid required");

    esp_err_t err = nvs_flash_init();
    if (err == ESP_ERR_NVS_NO_FREE_PAGES || err == ESP_ERR_NVS_NEW_VERSION_FOUND) {
        ESP_ERROR_CHECK(nvs_flash_erase());
        err = nvs_flash_init();
    }
    ESP_RETURN_ON_ERROR(err, TAG, "nvs init failed");

    s_events = xEventGroupCreate();
    ESP_RETURN_ON_FALSE(s_events, ESP_ERR_NO_MEM, TAG, "no mem");

    ESP_RETURN_ON_ERROR(esp_netif_init(), TAG, "netif init failed");
    ESP_RETURN_ON_ERROR(esp_event_loop_create_default(), TAG, "event loop failed");
    esp_netif_create_default_wifi_sta();

    wifi_init_config_t init_cfg = WIFI_INIT_CONFIG_DEFAULT();
    ESP_RETURN_ON_ERROR(esp_wifi_init(&init_cfg), TAG, "wifi init failed");

    ESP_ERROR_CHECK(esp_event_handler_instance_register(WIFI_EVENT, ESP_EVENT_ANY_ID,
                                                        on_wifi_event, NULL, NULL));
    ESP_ERROR_CHECK(esp_event_handler_instance_register(IP_EVENT, IP_EVENT_STA_GOT_IP,
                                                        on_wifi_event, NULL, NULL));

    wifi_config_t wifi_cfg = { 0 };
    strlcpy((char *)wifi_cfg.sta.ssid, ssid, sizeof(wifi_cfg.sta.ssid));
    if (password && password[0]) {
        strlcpy((char *)wifi_cfg.sta.password, password, sizeof(wifi_cfg.sta.password));
        wifi_cfg.sta.threshold.authmode = WIFI_AUTH_WPA2_PSK;
    } else {
        wifi_cfg.sta.threshold.authmode = WIFI_AUTH_OPEN;
    }

    ESP_RETURN_ON_ERROR(esp_wifi_set_mode(WIFI_MODE_STA), TAG, "set mode failed");
    ESP_RETURN_ON_ERROR(esp_wifi_set_config(WIFI_IF_STA, &wifi_cfg), TAG, "set config failed");
    ESP_RETURN_ON_ERROR(esp_wifi_start(), TAG, "wifi start failed");

    /* Power save adds tens of milliseconds of latency and jitter to every
     * transmission. For a real-time attitude stream you do not want it. */
    ESP_ERROR_CHECK(esp_wifi_set_ps(WIFI_PS_NONE));

    EventBits_t bits = xEventGroupWaitBits(s_events, BIT_CONNECTED | BIT_FAILED,
                                           pdFALSE, pdFALSE,
                                           pdMS_TO_TICKS(timeout_ms));
    if (bits & BIT_CONNECTED) {
        return ESP_OK;
    }
    ESP_LOGE(TAG, "failed to connect to '%s'", ssid);
    return ESP_ERR_TIMEOUT;
}
