akseliahonpera/embedded_systems_course_26/software/opengl_visualization_app/src/includes.hpp

#pragma once

#define GLM_ENABLE_EXPERIMENTAL

#include <GL/glew.h>
#include <GLFW/glfw3.h>
#include <GL/gl.h>
#include <glm/glm.hpp>
#include <glm/gtc/matrix_transform.hpp>
#include <glm/ext/scalar_constants.hpp>
#include <glm/gtc/quaternion.hpp>
#include <glm/gtc/type_ptr.hpp>
#include <glm/gtx/euler_angles.hpp>

#include <memory>
#include <string>
#include <iostream>
