akseliahonpera/embedded_systems_course_26/software/opengl_visualization_app/src/Utils.hpp

#pragma once

#include <string>
#include <vector>

namespace Utils
{

std::string readTextFile(std::string filepath);
std::vector<std::string> splitSpring(const std::string &str, char splitter);
double getTimeStamp();

}
