akseliahonpera/embedded_systems_course_26/(commit log)

2026-03-03 KiCad prokkis
    [esp.kicad_pcb, esp.kicad_sch]
2026-03-03 Update .gitignore for KiCAD project files
    Ignoret lisätty kicad projektia varten
2026-03-03 Tyhjät footprintit ja symbolit lisätty komponenteille jotka tarvitsee luoda itse
2026-03-03 tyhjät symboolit
    [esp.kicad_sch]
2026-03-03 symbolit tehty puuttuville komponenteille
    [esp.kicad_sch]
2026-03-04 Pari komponenttia powerille
    [esp.kicad_sch]
2026-03-04 konffit kuntoon
    [esp.kicad_sch]
2026-03-06 buck converter reference design
    [power_circuitry.kicad_sch]
2026-03-06 GNSS aloitettu
    [GNSS.kicad_sch, IMU.kicad_sch, MCU.kicad_sch, USB.kicad_sch, barometer.kicad_sch, esp.kicad_sch, power_supply.kicad_sch]
2026-03-07 GNSS WIP
    [GNSS.kicad_sch, esp.kicad_sch]
2026-03-08 interrupt output
    [barometer.kicad_sch, esp.kicad_sch]
2026-03-08 BNO085 lisätty kirjastoon
    [IMU.kicad_sch, esp.kicad_sch]
2026-03-08 power supply
    [power_circuitry.kicad_sch, power_supply.kicad_sch]
2026-03-09 hierarkiset pinnit poweriin
    [esp.kicad_sch, power_supply.kicad_sch]
2026-03-09 IMU schematic drawn
    [IMU.kicad_sch]
2026-03-09 tekstiä
    [IMU.kicad_sch, esp.kicad_sch, power_supply.kicad_sch]
2026-03-12 mohloilut korjattu
    [IMU.kicad_sch, esp.kicad_sch, power_supply.kicad_sch]
2026-03-12 footprinttejä
    [GNSS.kicad_sch, IMU.kicad_sch, USB.kicad_sch, barometer.kicad_sch, esp.kicad_sch, power_supply.kicad_sch]
2026-03-12 footprints for powersupply
    [power_supply.kicad_sch]
2026-03-12 power led
    [power_supply.kicad_sch]
2026-03-12 footprinttejä komponenteille + kapasitanssit korjattu imusta
    [GNSS.kicad_sch, IMU.kicad_sch]
2026-03-12 digikey field for power supply components
    [power_supply.kicad_sch]
2026-03-12 ajan tasalle
    [GNSS.kicad_sch, MCU.kicad_sch]
2026-03-12 paristo lisätty
    [GNSS.kicad_sch, IMU.kicad_sch, MCU.kicad_sch, USB.kicad_sch, barometer.kicad_sch, power_supply.kicad_sch]
2026-03-12 pin header
    [esp.kicad_sch, pin_header.kicad_sch]
2026-03-12 c5 korjattu
    [power_supply.kicad_sch]
2026-03-12 välipusku
    [IMU.kicad_sch, MCU.kicad_sch, esp.kicad_sch]
2026-03-12 imu johot
    [MCU.kicad_sch, esp.kicad_sch]
2026-03-13 yksi johto paremmin
    [barometer.kicad_sch]
2026-03-13 piuhat vedetty mculla ja i2c pullupit mculle
    [IMU.kicad_sch, MCU.kicad_sch, USB.kicad_sch]
2026-03-13 dpdt switch
    [bom.xls, esp.csv, power_supply.kicad_sch]
2026-03-13 pom päivetty
    [bom.xls]
2026-03-13 ERC hiljennetty
    [GNSS.kicad_sch, IMU.kicad_sch, MCU.kicad_sch, USB.kicad_sch, barometer.kicad_sch, esp.kicad_sch, pin_header.kicad_sch, power_supply.kicad_sch]
2026-03-23 more comments
    [GNSS.kicad_sch, IMU.kicad_sch, MCU.kicad_sch, USB.kicad_sch, barometer.kicad_sch, pin_header.kicad_sch, power_supply.kicad_sch]
2026-03-23 everything in single sheet
    [everything_in_single_sheet.kicad_sch]
2026-04-02 headerit mietitty, pinnijärjestystä muutettu mcussa
    [MCU.kicad_sch, esp.kicad_sch, pin_header.kicad_sch]
2026-04-02 UART1 siirretty parempaan paikkaan
    [MCU.kicad_sch]
2026-04-02 powersupply pcb
    [powersupply.kicad_pcb]
2026-04-02 imu pcb v1
    [esp.imu_pcb_v1.kicad_pcb]
2026-04-02 imu pcb v1_
2026-04-02 jumper pins for disconnecting power supply
    [pin_header.kicad_sch, power_supply.kicad_sch]
2026-04-03 gepsiä alotettu
    [MCU.kicad_sch, esp.kicad_pcb]
2026-04-06 wippistä
    [MCU.kicad_sch, esp.kicad_pcb, pin_header.kicad_sch]
2026-04-07 power supply to pcb
    [esp.kicad_pcb]
2026-04-07 wider GND traces on power supply
    [esp.kicad_pcb]
2026-04-07 backside GND fill
    [esp.kicad_pcb]
2026-04-07 all connected for now
    [esp.kicad_pcb]
2026-04-07 wider power trace for MCU
    [esp.kicad_pcb]
2026-04-07 copper fillin minimietäisyys laskettu vastaamaan valmistajan speksiä, vioja yms
    [MCU.kicad_sch, esp.kicad_pcb]
2026-04-10 gerberit 2. yritys
    [esp-B_Cu.gbl, esp-B_Mask.gbs, esp-B_Paste.gbp, esp-B_Silkscreen.gbo, esp-Edge_Cuts.gm1, esp-F_Cu.gtl, esp-F_Mask.gts, esp-F_Paste.gtp]
2026-04-10 power supply FB circuitry to better place
    [esp.kicad_pcb]
2026-04-10 barometri interrupt viety muualta kuin sirun alta
    [esp.kicad_pcb]
2026-04-10 fixed via positions and power trace width
    [esp-B_Cu.gbl, esp-B_Mask.gbs, esp-B_Paste.gbp, esp-B_Silkscreen.gbo, esp-Edge_Cuts.gm1, esp-F_Cu.gtl, esp-F_Mask.gts, esp-F_Paste.gtp]
2026-04-12 more vias close to USB GNDs
    [esp-B_Cu.gbl, esp-B_Mask.gbs, esp-B_Paste.gbp, esp-B_Silkscreen.gbo, esp-Edge_Cuts.gm1, esp-F_Cu.gtl, esp-F_Mask.gts, esp-F_Paste.gtp]
2026-04-12 changed voltage regulator footprint
    [esp-B_Cu.gbl, esp-B_Mask.gbs, esp-B_Paste.gbp, esp-B_Silkscreen.gbo, esp-Edge_Cuts.gm1, esp-F_Cu.gtl, esp-F_Mask.gts, esp-F_Paste.gtp]
2026-04-12 new gerber zip
2026-06-12 barometri poweri testiä
2026-07-14 IMU API puskettu
2026-09-02 imu toimii
2026-09-04 lisatty repoon wifi toteutuksesta esiversio, udp clientistä buginen esiversio, potentiaalista ohjelmalogiikkaa tietorakenteiden ja taskien osalta yms
    [main.c]
2026-09-06 visualisointiäppi
    [monkey.obj]
2026-09-06 dronen malli ja servuntynkää
    [drone.obj, monkey.obj, prop.obj]
2026-09-28 crossplatform sockets + cross compiling for windows
2026-09-30 IMU bias, kovarianssi ja komentoja
2026-10-01 printtejä
2026-10-19 komentoja ground stationilta
2026-10-20 WIP cmds for sensors
2026-11-09 nyt näyttäis toimivan ja pohjoinen osoittaa pohjoiseen. Jouduin vaihtamaan applikaation ypr:n laskun samaksi kuin firmwaressa, ja muokkaamaan kvaternion etumerkkejä. TODO: kiihtyvyydet on eri framess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
2026-11-10 kiihtyvyydet samaan frameen rotaatioiden kanssa
